ruenahcmohr/oldMeter/README.md

# oldMeter
old panel meter model for DIY meters. w/steampunk opts

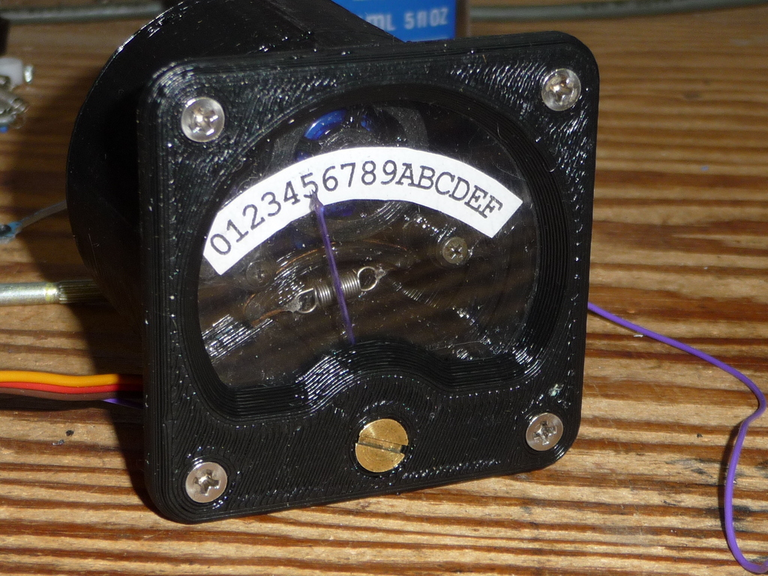
[picture p1: guide/p1290470.jpg]


The assembly guide is under the "guide" folder, but none of it seems to be viewable within github.
Maybe try the pdf?

Just for the record, I hate markdown.
