ruenahcmohr/oldMeter/p1290286.jpg

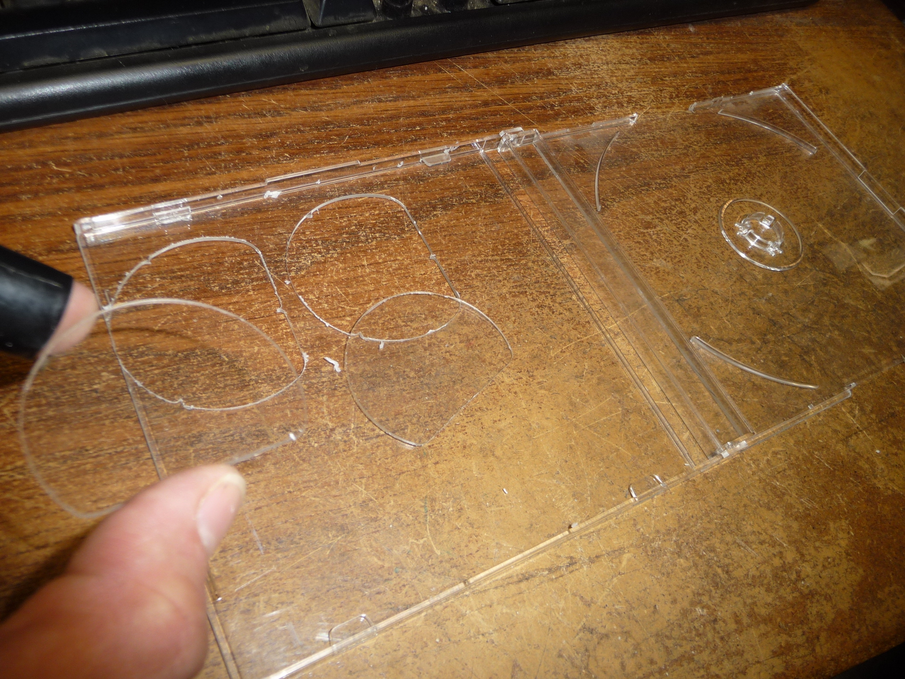
p1290286.jpg
