ruenahcmohr/oldMeter/p1290287.jpg

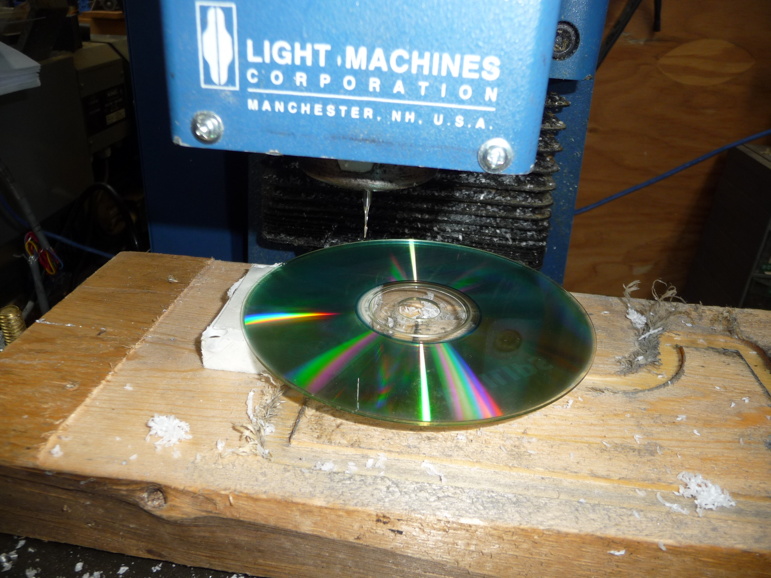
p1290287.jpg
