ruenahcmohr/oldMeter/p1290292.jpg

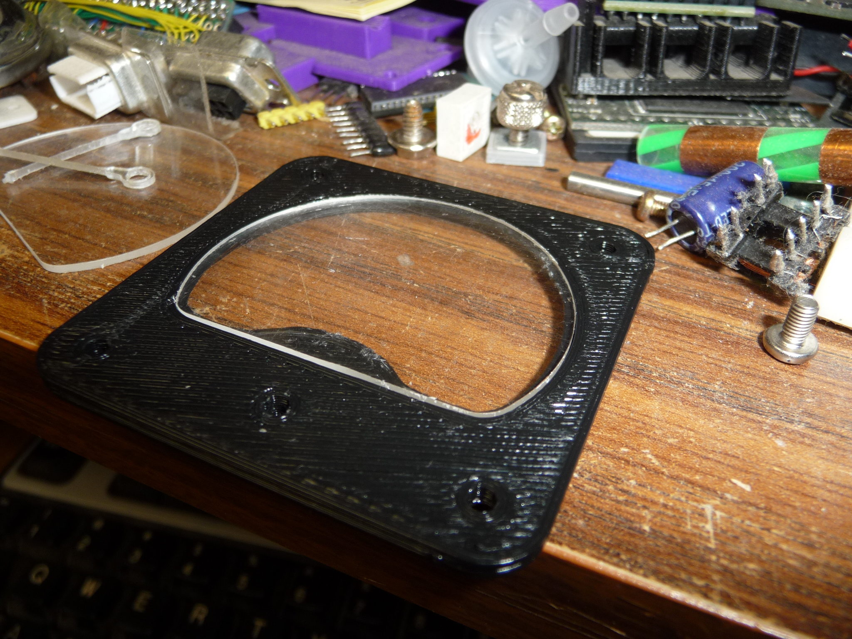
p1290292.jpg
