ruenahcmohr/oldMeter/p1290298.jpg

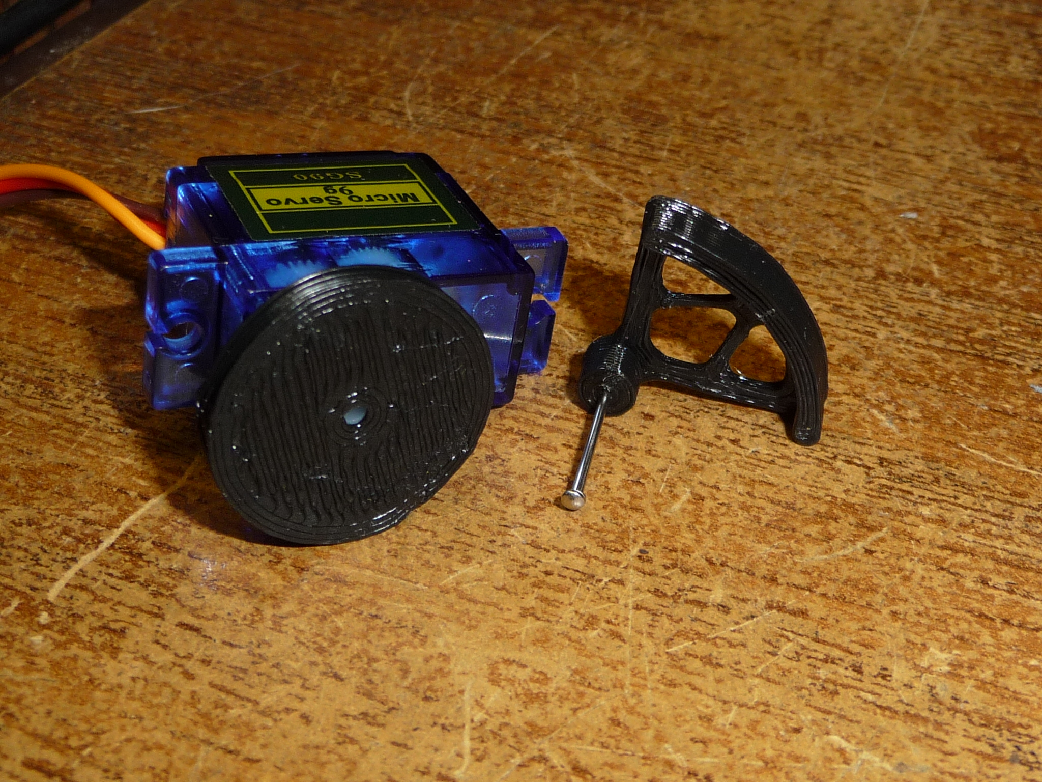
p1290298.jpg
