ruenahcmohr/oldMeter/p1290318.jpg

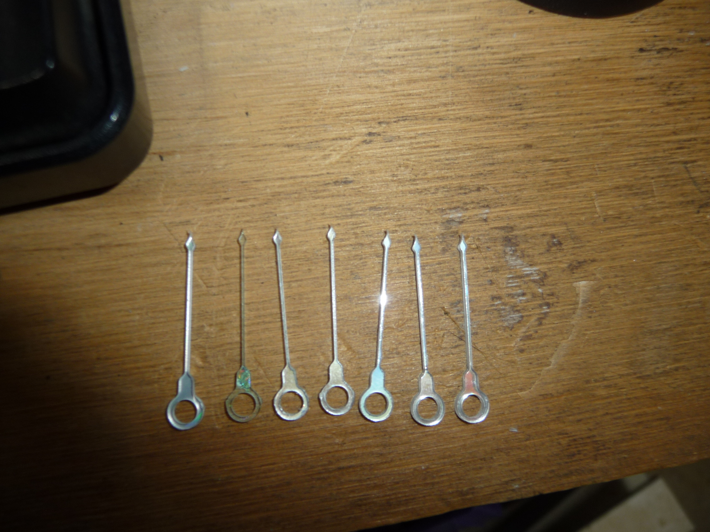
p1290318.jpg
