ruenahcmohr/oldMeter/p1290329.jpg

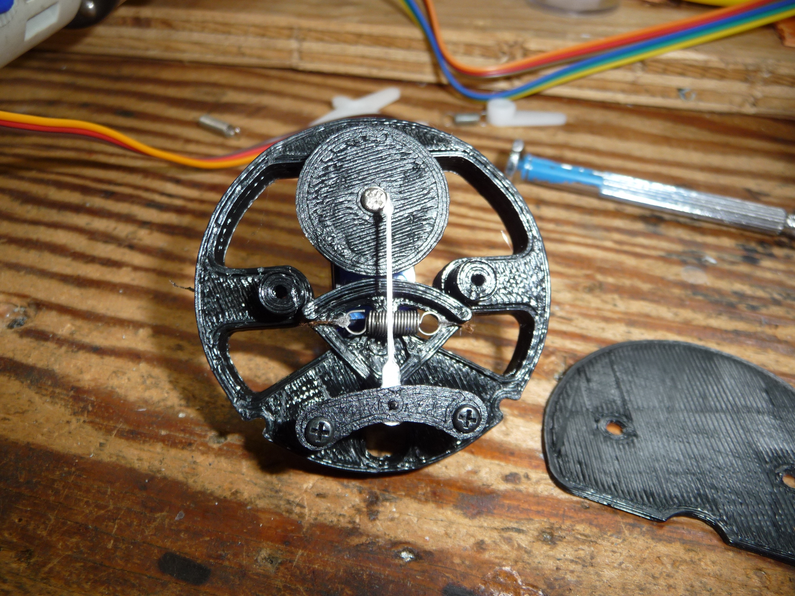
p1290329.jpg
