ruenahcmohr/oldMeter/p1290336.jpg

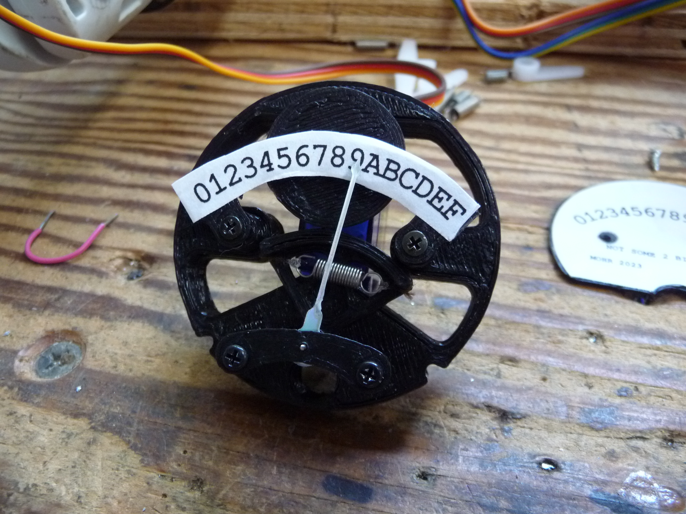
p1290336.jpg
