ruenahcmohr/oldMeter/p1290357.jpg

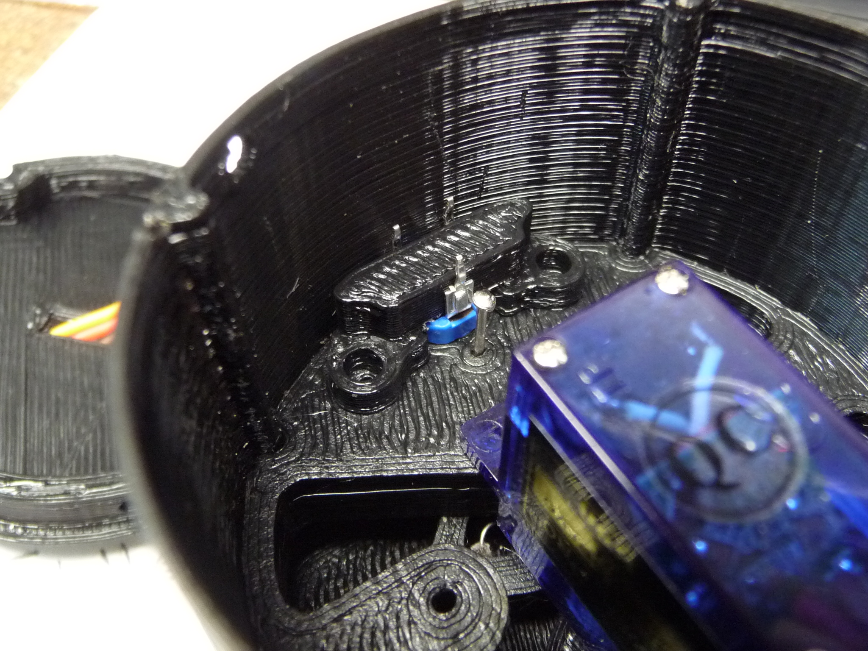
p1290357.jpg
