ruenahcmohr/oldMeter/p1290383.jpg

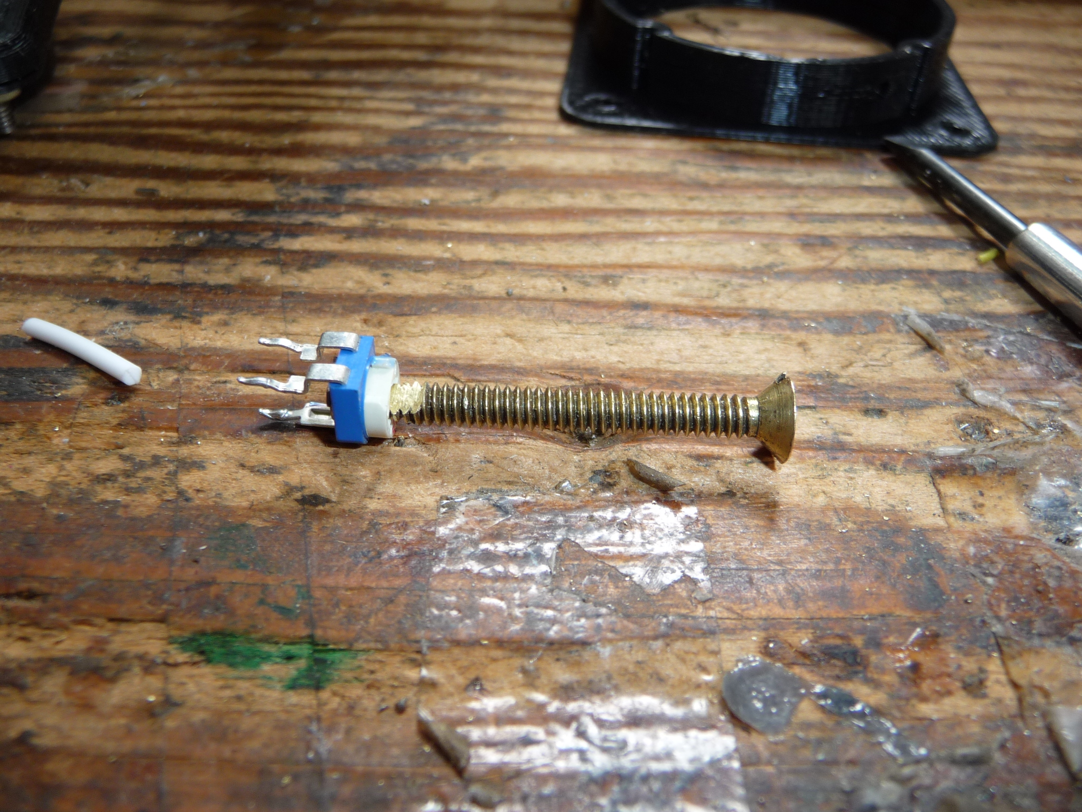
p1290383.jpg
