ruenahcmohr/oldMeter/p1290386.jpg

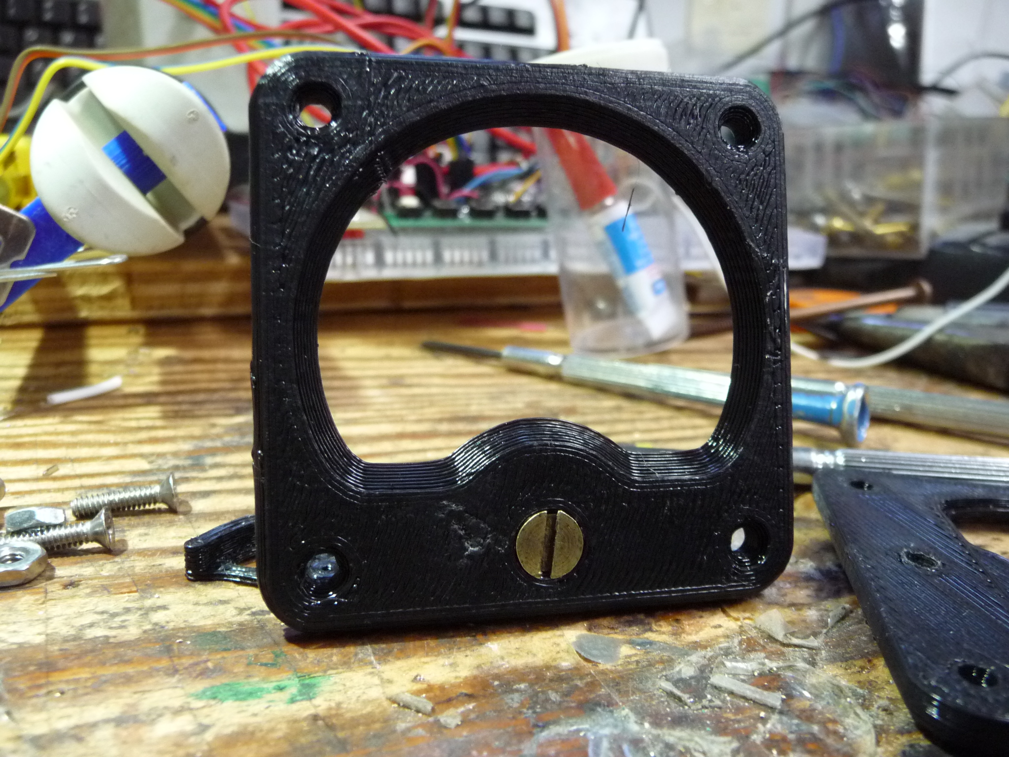
p1290386.jpg
