ruenahcmohr/oldMeter/p1290387.jpg

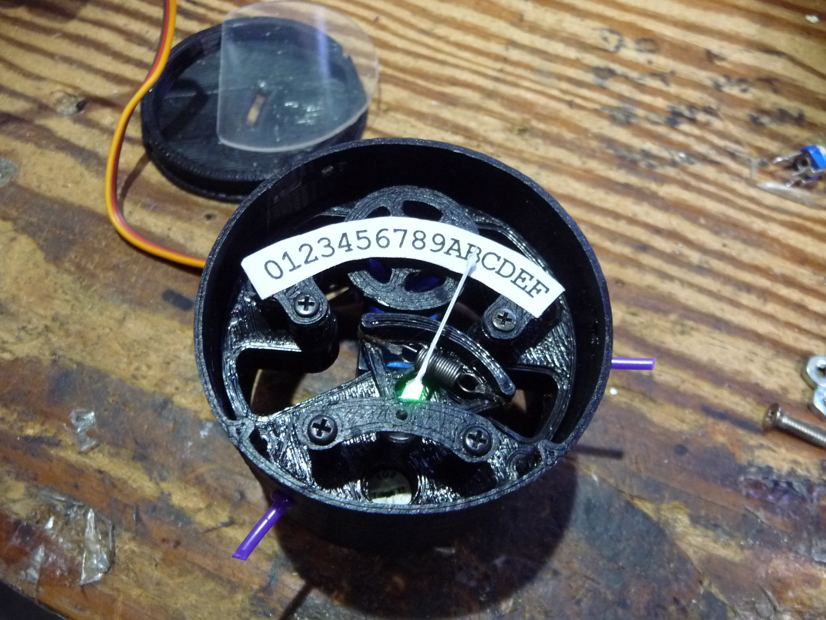
p1290387.jpg
