ruenahcmohr/oldMeter/p1290389.jpg

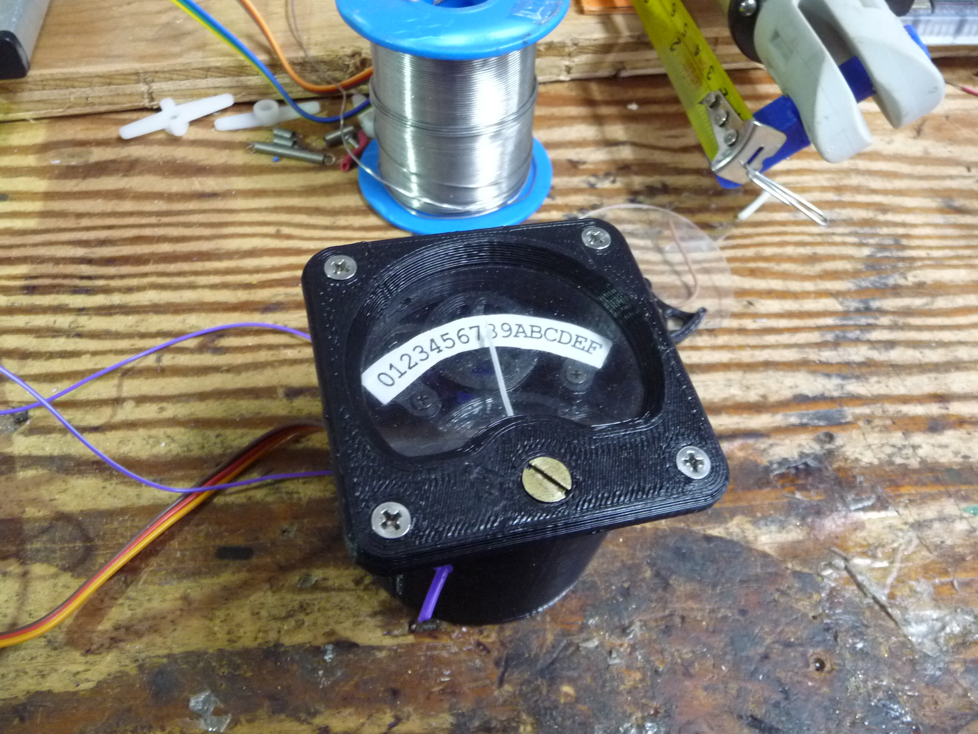
p1290389.jpg
