ruenahcmohr/oldMeter/p1290392.jpg

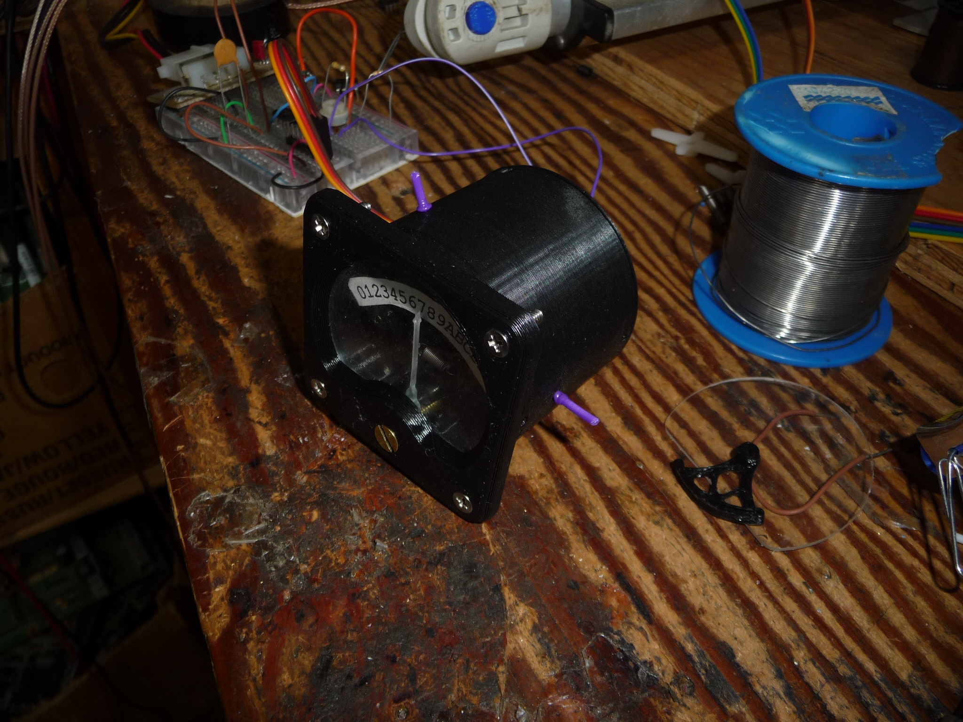
p1290392.jpg
