ruenahcmohr/oldMeter/main.dxf

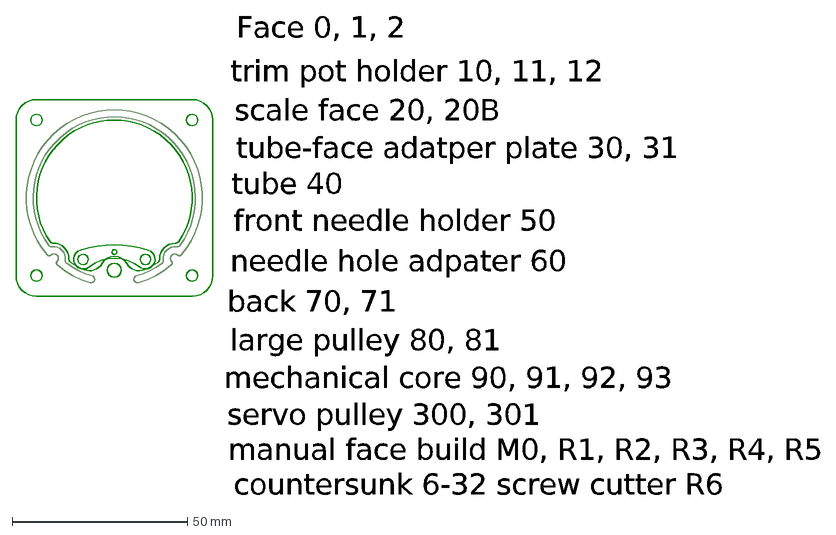
[picture p15: CAD file, 2023-09-11]
main.dxf
Face 0, 1, 2
trim pot holder 10, 11, 12
scale face 20, 20B
tube-face adatper plate 30, 31
tube 40
front needle holder 50
needle hole adpater 60
back 70, 71
large pulley 80, 81
mechanical core 90, 91, 92, 93
servo pulley 300, 301
manual face build M0, R1, R2, R3, R4, R5
countersunk 6-32 screw cutter R6
