ruenahcmohr/oldMeter/pulley-r6-s.stl

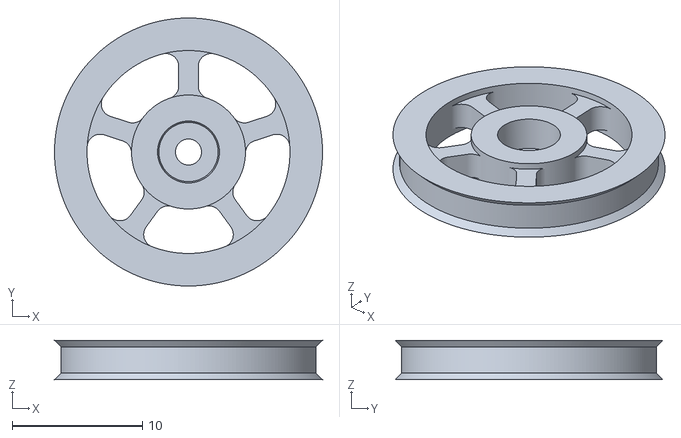
[picture p16: CAD file, 2023-09-18]
pulley-r6-s.stl
20.6 x 20.6 x 3.00
