ruenahcmohr/oldMeter/pinsupport-r3-s.stl

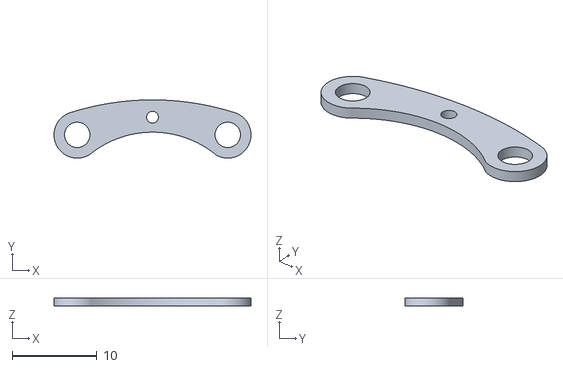
[picture p17: CAD file, 2023-09-11]
pinsupport-r3-s.stl
23.3 x 6.89 x 1.00
