ruenahcmohr/oldMeter/backfaceB-r1-s.stl

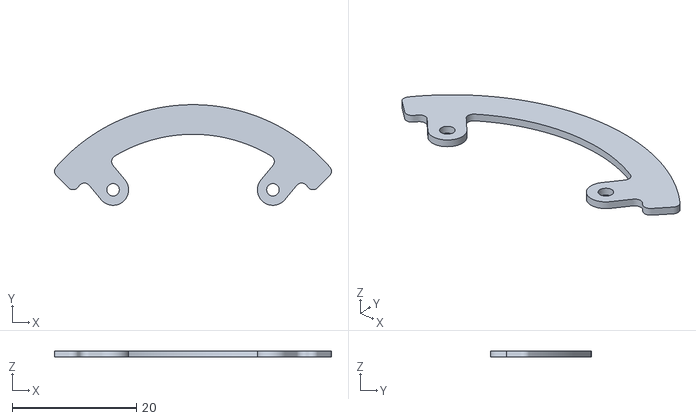
[picture p18: CAD file, 2023-09-11]
backfaceB-r1-s.stl
44.6 x 16.2 x 1.00
