ruenahcmohr/oldMeter/backcap-r3-s.stl

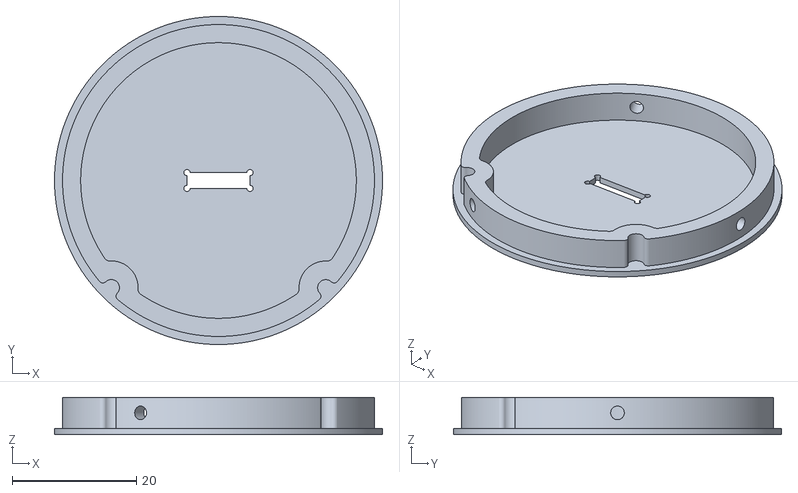
[picture p19: CAD file, 2023-09-11]
backcap-r3-s.stl
52.9 x 52.9 x 6.00
