ruenahcmohr/oldMeter/tube-r2-s.stl

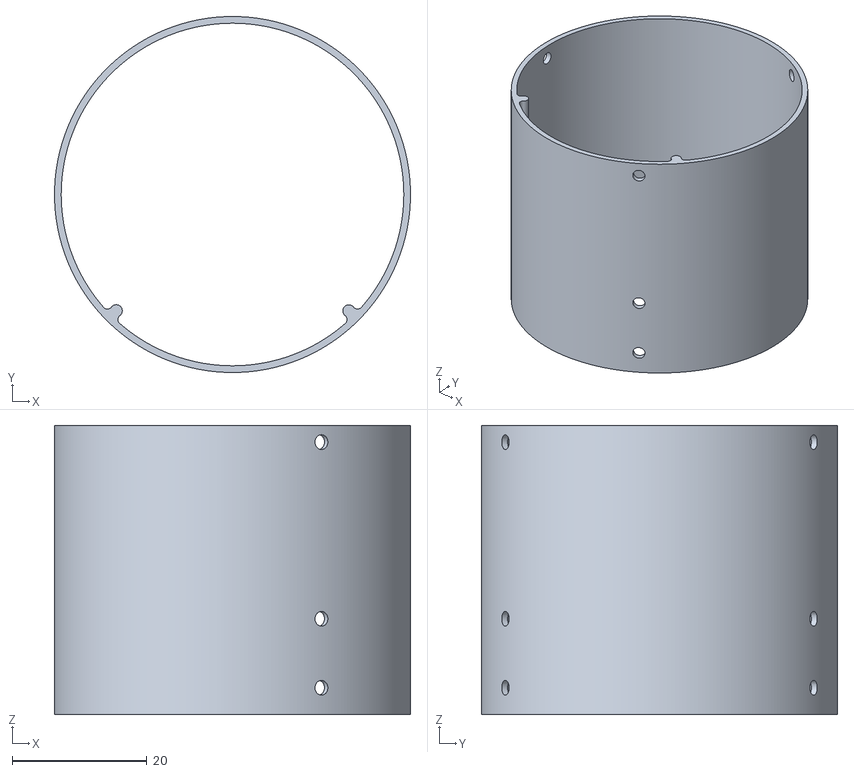
[picture p20: CAD file, 2023-09-11]
tube-r2-s.stl
52.9 x 52.9 x 43.0
