ruenahcmohr/oldMeter/motorFrame-r4-s.stl

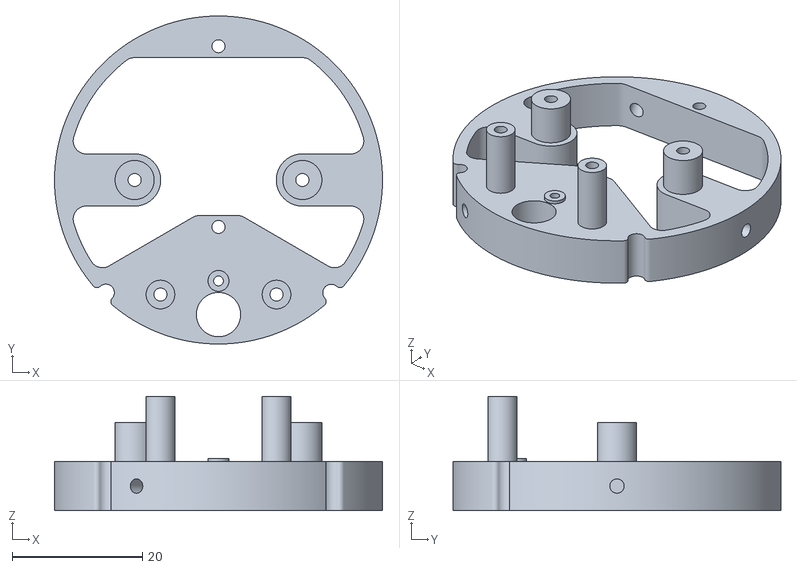
[picture p21: CAD file, 2023-09-11]
motorFrame-r4-s.stl
50.3 x 50.3 x 17.5
