ruenahcmohr/oldMeter/trimLock-r1-s.stl

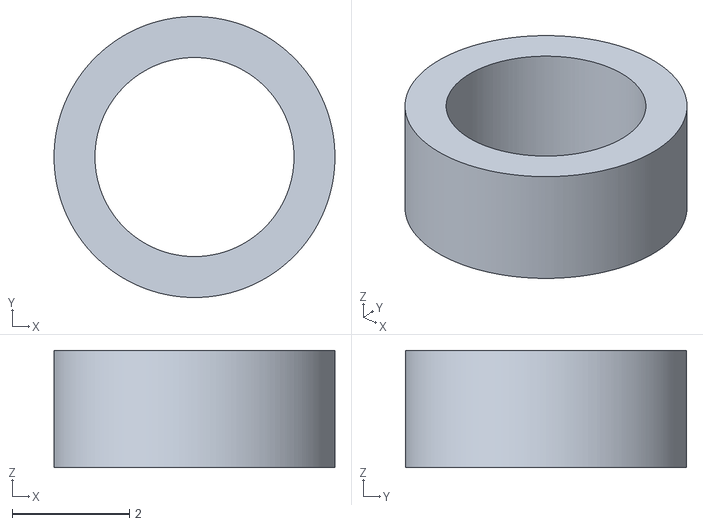
[picture p22: CAD file, 2023-09-11]
trimLock-r1-s.stl
4.80 x 4.80 x 2.00
