ruenahcmohr/oldMeter/adapterFlange-r4-s.stl

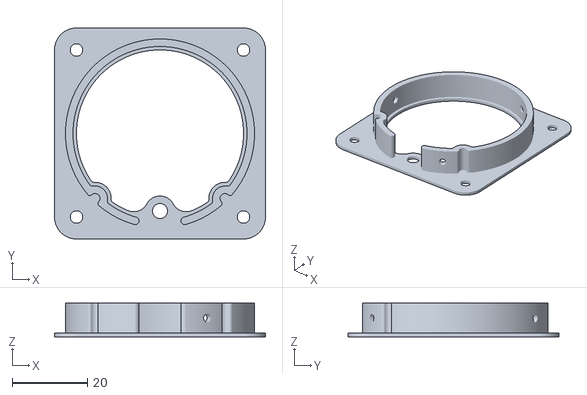
[picture p23: CAD file, 2023-09-11]
adapterFlange-r4-s.stl
56.2 x 56.2 x 9.00
