ruenahcmohr/oldMeter/pulley2-r2-s.stl

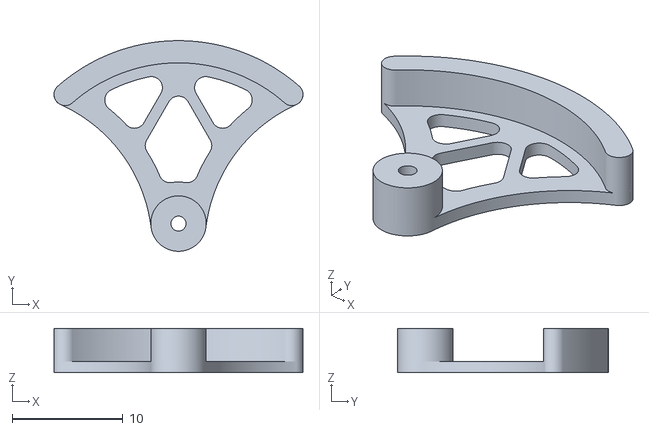
[picture p24: CAD file, 2023-09-11]
pulley2-r2-s.stl
22.5 x 19.0 x 4.00
