ruenahcmohr/oldMeter/Guage2-test.stl

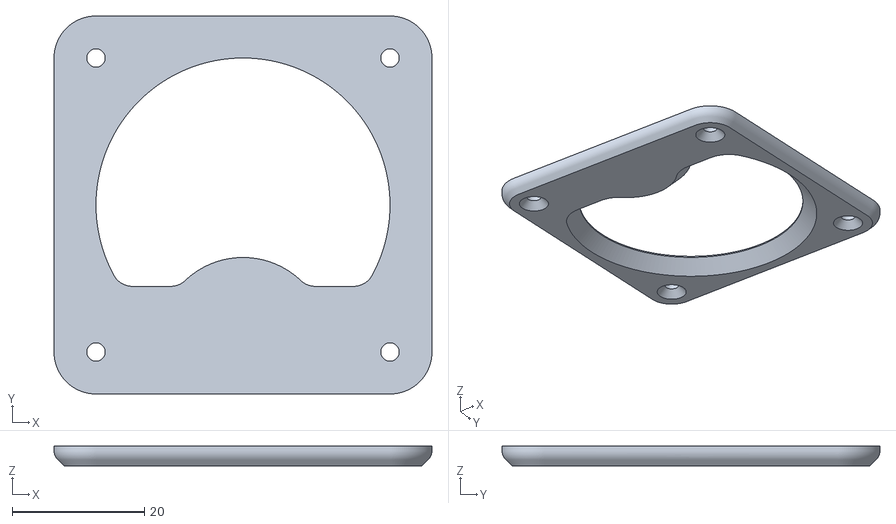
[picture p25: CAD file, 2023-09-11]
Guage2-test.stl
57.2 x 57.2 x 3.00
