ruenahcmohr/oldMeter/backface-r2-s.stl

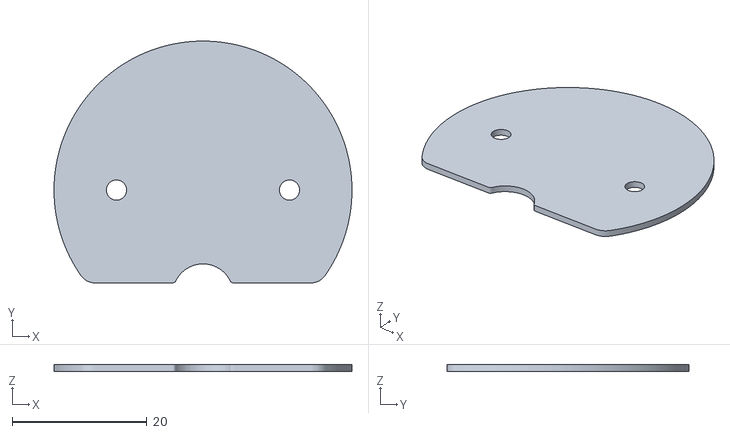
[picture p26: CAD file, 2023-09-11]
backface-r2-s.stl
44.3 x 35.9 x 1.00
