ruenahcmohr/oldMeter/needleHub-r3-s.stl

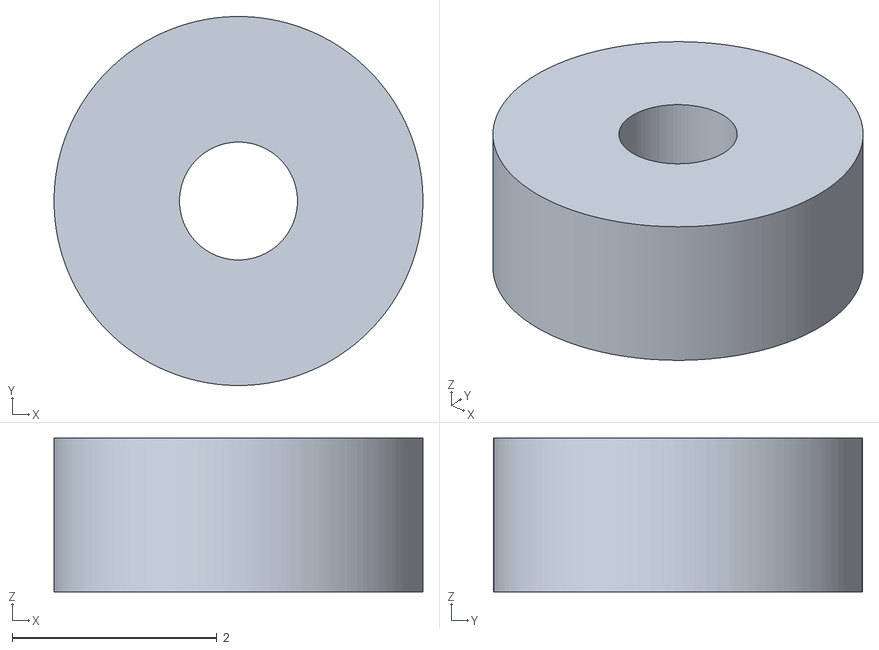
[picture p27: CAD file, 2023-09-11]
needleHub-r3-s.stl
3.60 x 3.60 x 1.50
