ruenahcmohr/oldMeter/potBracket-r2-s.stl

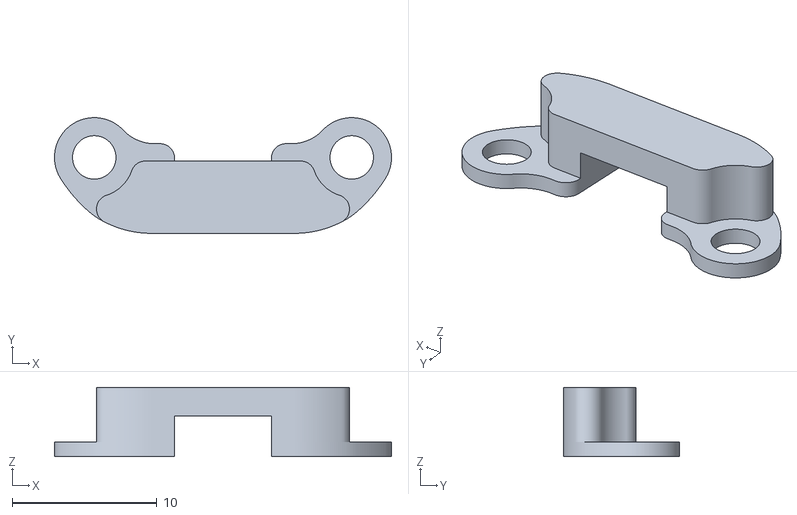
[picture p28: CAD file, 2023-09-11]
potBracket-r2-s.stl
23.3 x 8.00 x 4.80
