ruenahcmohr/oldMeter/needle-r1-s.stl

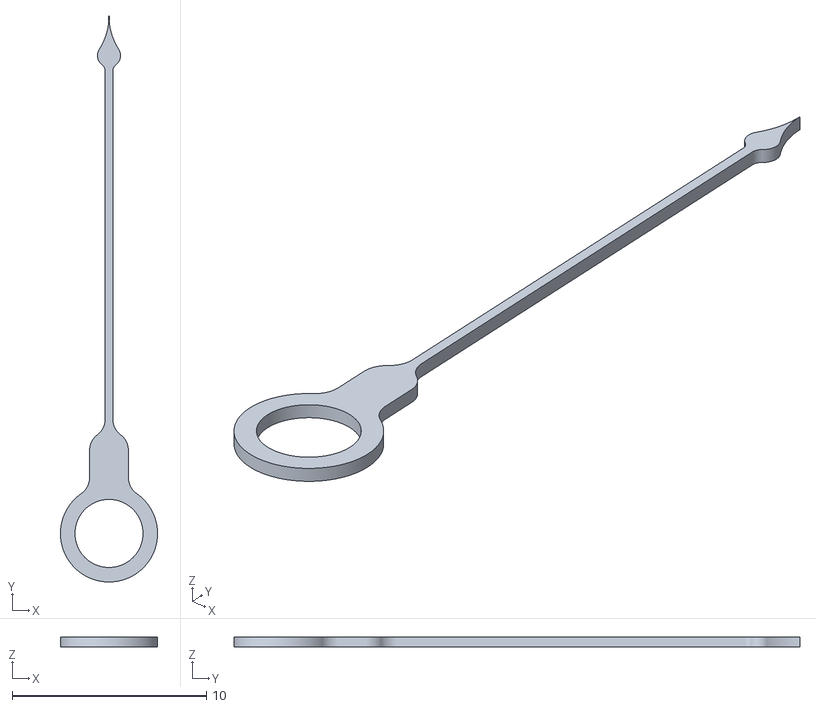
[picture p29: CAD file, 2023-09-07]
needle-r1-s.stl
5.00 x 29.1 x 0.5
