ruenahcmohr/oldMeter/guide/p1290463.jpg

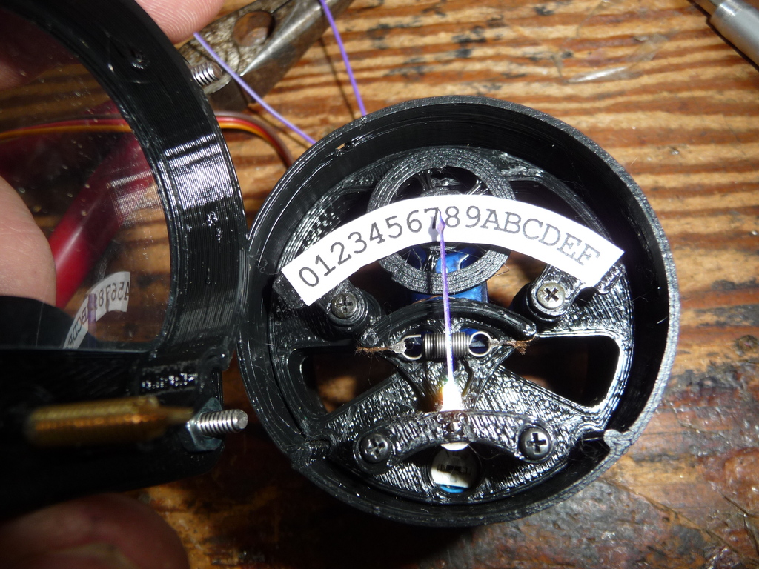
guide/p1290463.jpg
