ruenahcmohr/oldMeter/needle.pdf

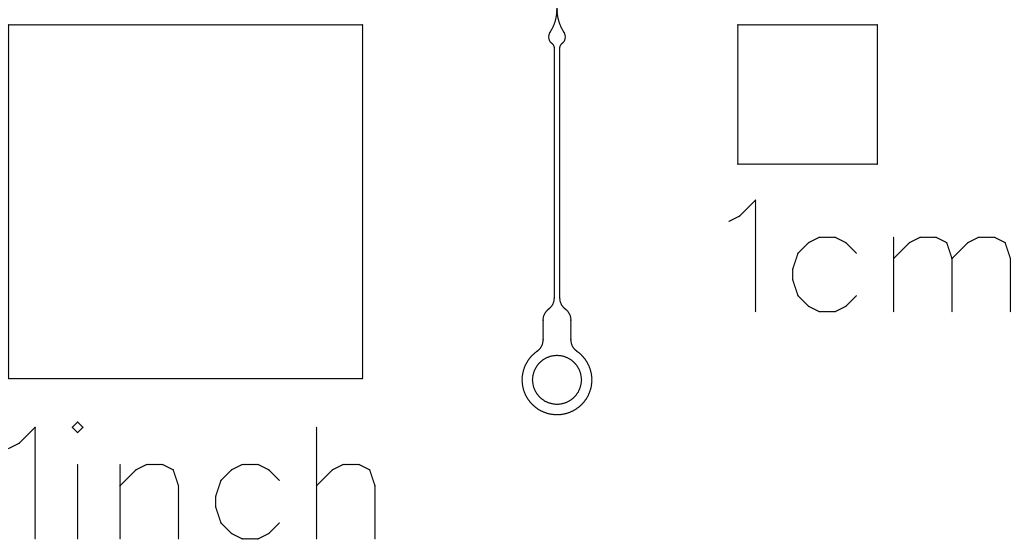
[picture p65: page 1]
