ruenahcmohr/oldMeter/(commit log)

2023-09-07 some uploads, more later
    [needle-r1-s.stl]
2023-09-11 first rev STL files
    [Guage2-test.stl, adapterFlange-r4-s.stl, backcap-r3-s.stl, backface-r2-s.stl, backfaceB-r1-s.stl, main.dxf, main.scad, motorFrame-r4-s.stl]
2023-09-18 adding assembly guide
    [pulley-r5-s.stl, pulley-r6-s.stl]
2023-09-18 Update README.md
    added assembly guide pointer
